heyboiiiii/PLC_ESP32/apps/readme.md

IOT_ladder_editor:**aplication to create the ladder code and get it in arduino**.

transform_code: **aplication to pass the arduino code to C for esp32(espressif) code**.

use: python rewrite.py plc.ino(generate from IOTLADDDEREDITOR) plc.c(or dest.)
