heyboiiiii/PLC_ESP32/hardware/readme.md

**circuit and schematic design were made in proteus(8.1)**.
