heyboiiiii/PLC_ESP32/docs/Carpeta Técnica PLC.pdf

# PLC

## PLC con microcontrolador ESP32

## Carpeta Técnica

Della Torre, Joaquín

Erbino, Renzo

Romero Dominguez, Braulio

Villegas González, Alejandro

2024

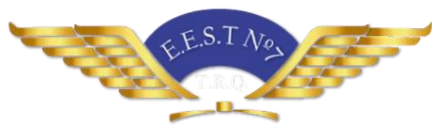
[picture p11: figure]

Índice

1. Preámbulo | 3
1.3.3. Lenguajes de programación y frameworks
2. Introducción | 4
3. Desarrollo técnico | 5
4. Placa | 9
5. Página web | 10
6. Código de la placa | 10

## 1. Preámbulo

1.1. ¿Quiénes somos?
- Braulio Romero Domínguez

Mail: braulioemilioromero7@gmail.com

DNI: 48.838.123

- Villegas González Alejandro

Mail: advillegasg@gmail.com

DNI: 48.572.234

- Della Torre Joaquín

Mail: jaoquin1234@gmail.com

DNI: 48.240.913

- Erbino Renzo

Mail: renzoerbino@gmail.com

DNI: 48.944.402

### 1.2. Docentes a cargo

- Fabrizio Carlassara
- Agustin Palmieri Hise

### 1.3. Información adicional

### 1.3.1. Tiempo invertido

- Fecha de inicio: 6 de agosto de 2024.
- Duración: 16 semanas de trabajo.
- Esfuerzo del proyecto individual: 3 horas de trabajo

semanales por integrante.

- Esfuerzo total del proyecto: 192 horas de trabajo.

### 1.3.2. Programas utilizados

- Usamos Visual Studio Code para programar el

ESP32

- iot-ladder-editor, un programa que utilizamos para

programar en Ladder. https://github.com/leofds/iot-

ladder-editor/tree/main
1.3.3. | Lenguajes | de | programación | y

frameworks utilizados

- Python
- Ladder
- C

## 2. Introducción

### 2.1. Resumen del proyecto

Se busca aplicar las funciones de un PLC tradicional, el cual a grandes rasgos se encarga de detectar diversos tipos de señales del proceso, y elaborar y enviar acciones de acuerdo con lo que se ha programado. Además, recibe configuraciones de los programadores y da reporte a los mismos, aceptando modificaciones de programación cuando son necesarias
Pero se utiliza buscando una simplificación en el ámbito de utilizar un microcontrolador ESP32 como núcleo de las operaciones, el cual estará conectado a una página web que mostrará un análisis de datos recaudados y el programa del PLC el cual podrá ser modificado siempre que se desee a través de esa página
2.2. ¿Por qué usar un PLC?

Los PLCs permiten controlar y automatizar procesos industriales, reduciendo la necesidad de intervención manual y aumentando la precisión y consistencia en las operaciones. Son como cerebros programables que hacen que las cosas funcionen automáticamente y de manera eficiente. Además, con un microcontrolador abarataríamos costo, reduciríamos el tamaño, sería más fácil de programar e incluso se le podrían añadir funciones de Wifi o Bluetooth

### 2.3. PLCs en la industria

Los PLC se usan en la automatización industrial para controlar procesos y maquinaria en industrias como la automotriz, alimentaria y química, así como en sistemas de energía, edificios y transporte automatizado por ejemplo en
automatización | de | procesos | industriales, | control | de
máquinas, sistemas de transporte y logística y gestión de energía.

### 2.4. Impacto medioambiental

Los PLCs optimizan procesos industriales, reduciendo el consumo energético al eliminar desperdicios y ajustando operaciones para usar solo la energía necesaria, además son esenciales en la operación de sistemas de energía renovable. Al mismo tiempo, contienen componentes electrónicos que requieren recursos como metales, plásticos y tierras raras para su fabricación, lo que puede generar impacto ambiental durante la extracción y procesamiento de estos materiales, teniendo en cuenta que su producción contribuye a emisiones de CO2 y que consumen energía durante su operación, y su impacto depende de la fuente de energía utilizada.

## 3. Desarrollo técnico

### 3.1. Descripción del funcionamiento

El PLC lee lo que hay en las entradas y según esto usa la lógica que dice que si tal entrada esta en tal estado activa tal salida, y dentro del ESP32 tiene varios archivos de configuración con un archivo de LCD que te muestra lo que está sucediendo. Se conecta al Wifi e inicia un servidor web con su IP, donde lo accedes y ves el estado de entradas y salidas del PLC. Manda a correr el archivo del plc.c, donde está la lógica del PLC que al cambiar algún estado se refresca la pagina, después de iniciar el servidor web.

### 3.1.1 Descripción de las entradas

Las borneras tienen las entradas digitales y analógicas (I1 a I4 e IA5 a IA6 respectivamente) y también poseen los 24V y su GND. N solo cumple la función de neutro respecto a todas las entradas digitales, mientras que el neutro de las analógicas es IN-.

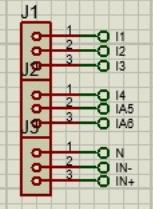
[picture p12: figure]

Posee cuatro de las seis entradas digitales, estas funcionan con un optoacoplador el cual es generalmente utilizado para reducir la señal eléctrica que ingresa de 12V o 24V a un rango de 0 a 3.3V, lo que el microcontrolador es capaz de soportar. Este método es generalmente usado para las entradas de los microprocesadores.

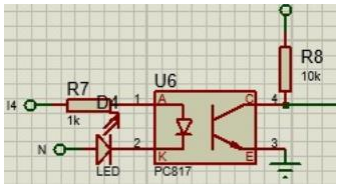
[picture p13: figure]

En las entradas analógicas tenemos una reducción de tensión, que pasará de 0V-10V a una menor, que pueda aceptar el microcontrolador, mediante una relación a través de la primera parte. Luego tenemos un seguidor de tensión que separa la entrada de la salida que luego va conectada al microcontrolador.

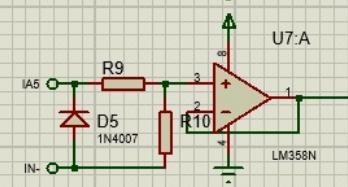
[picture p14: figure]

### 3.1.2 Descripción de las salidas

Tiene una salida con etapa de potencia de relé, la cual funciona a través del mecanismo básico de etapa de potencia de relé y es uno de los dos tipos de salida que posee el PLC. Esto se realiza de esta manera para tener el control de las salidas de grandes potencias de una manera más segura y eficiente.

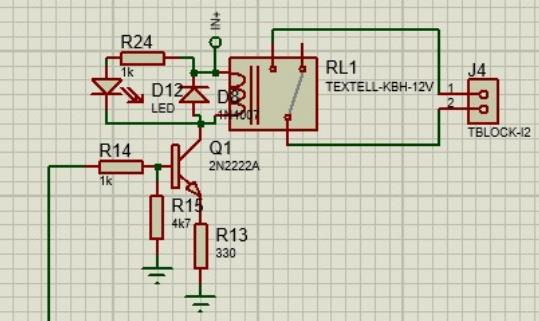
[picture p15: figure]

Las salidas transistorizadas en un PLC se utilizan cuando se requiere una respuesta rápida, un alto número de conmutaciones y el manejo de señales digitales, pero con la limitación de manejar cargas de menor potencia que las salidas de relé.

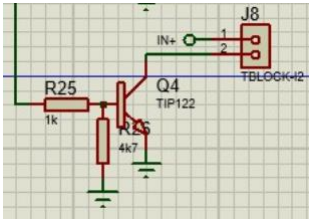
[picture p16: figure]
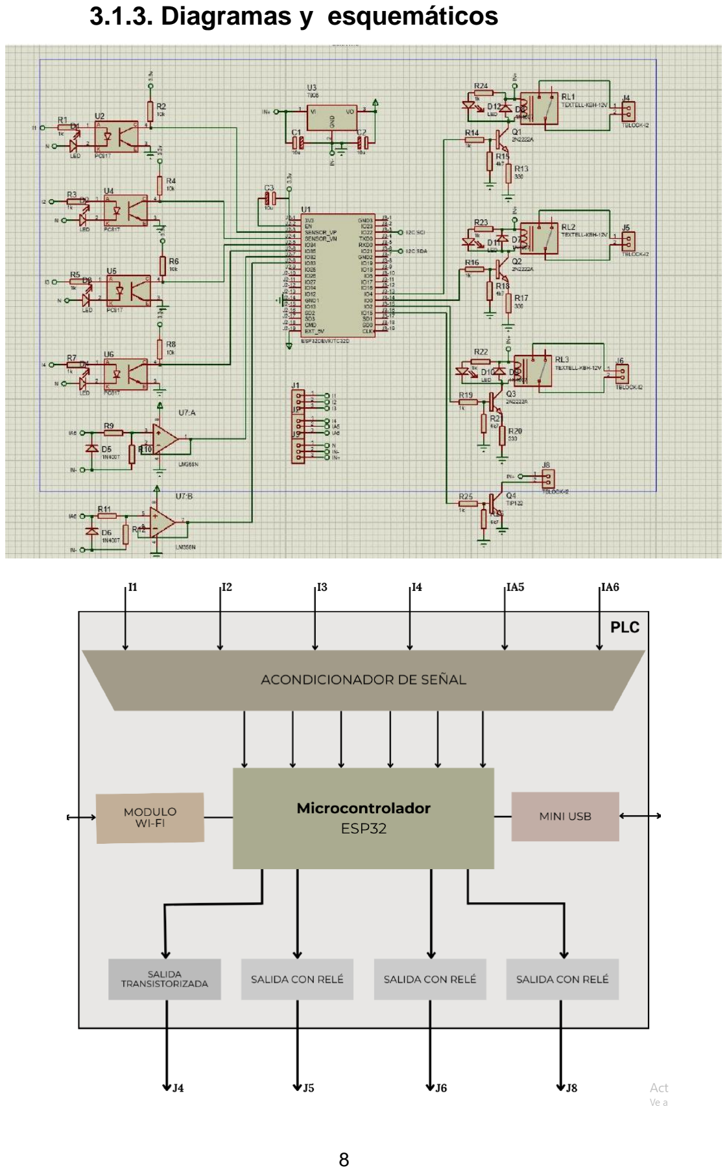
[picture p17: page 8]

### 3.1.3. Diagramas y esquemáticos

## 4. Placa

### 4.1. Componentes

- U1 – ESP32
- U2, U4, U5, U6 – PC817
- U3 – LM7805
- U7 – LM358N
- Q1, Q2, Q3 – 2N2222A
- Q4 – TIP122
- 26x Resistencia
- 8x Bornera
- 12x Diodo
- 3x Relé
- 3x Capacitor

### 4.2. Costos

- ESP32 ≈ 10000$
- 4x PC817 ≈ 3000$
- LM7805 ≈ 2500$
- LM358N ≈ 3400$
- 3x 2N2222A ≈ 2300$
- TIP122 ≈ 2500$
- 26x Resistencia ≈ 2000$
- 8x Bornera ≈ 6000$
- 12x Diodo ≈ 5000$
- 3x Relé ≈ 4000$
- 3x Capacitor ≈ 1000$

Precio total ≈ 41700$

## 5. Página

### 5.1. Funcionamiento

Al entrar a la página tienes un web_server.c, el código del servidor web que describe los eventos, es decir, que hacer cuando alguien entra a la página, que mostrarle y le devuelve el html con el javascript dentro y te muestra las entradas y salidas del PLC, de forma paralela es decir, que si se altera el estado de una de las entradas o salidas se refresca la página.

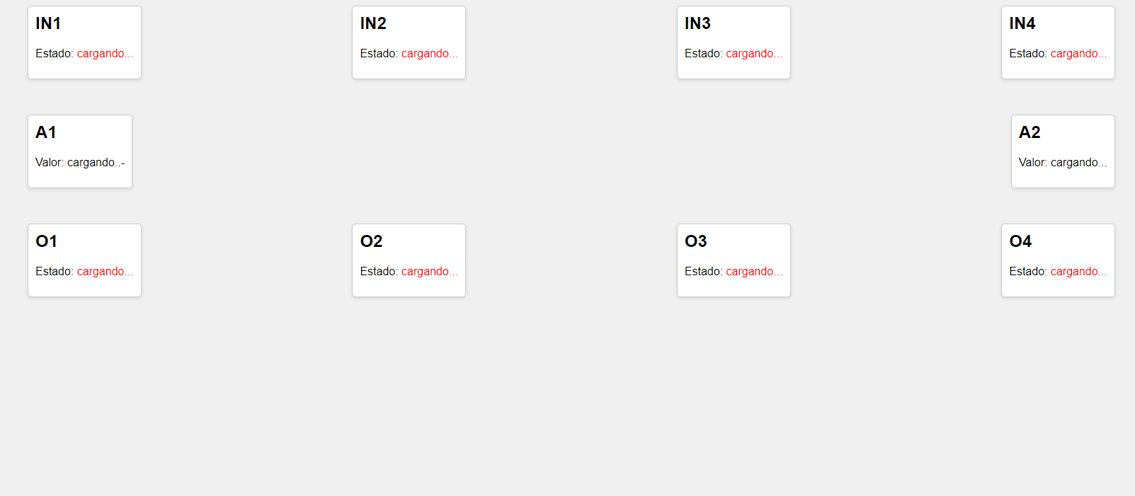
[picture p18: figure]

## 6. Código de la placa

### 6.1. Lenguaje Ladder

Este es un lenguaje de programación gráfica utilizado principalmente para programar PLCs. Es muy popular en la automatización industrial debido a su similitud con los diagramas eléctricos utilizados tradicionalmente en circuitos de control eléctrico y su facilidad de interpretación por parte de técnicos e ingenieros, especialmente para aquellos que migran de sistemas de relés a sistemas programables. Por otra parte, se optimizó el código para que no ocupe espacio en memoria

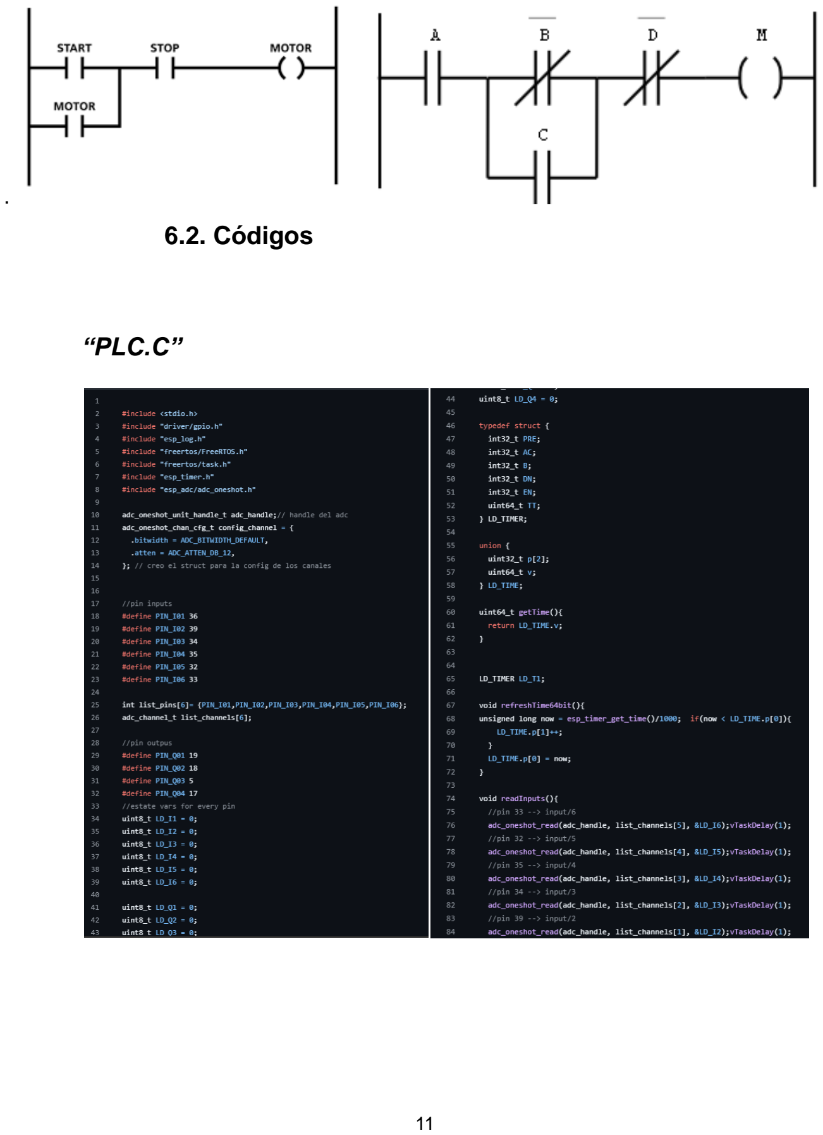
[picture p19: page 11]

### 6.2. Códigos

“PLC.C”

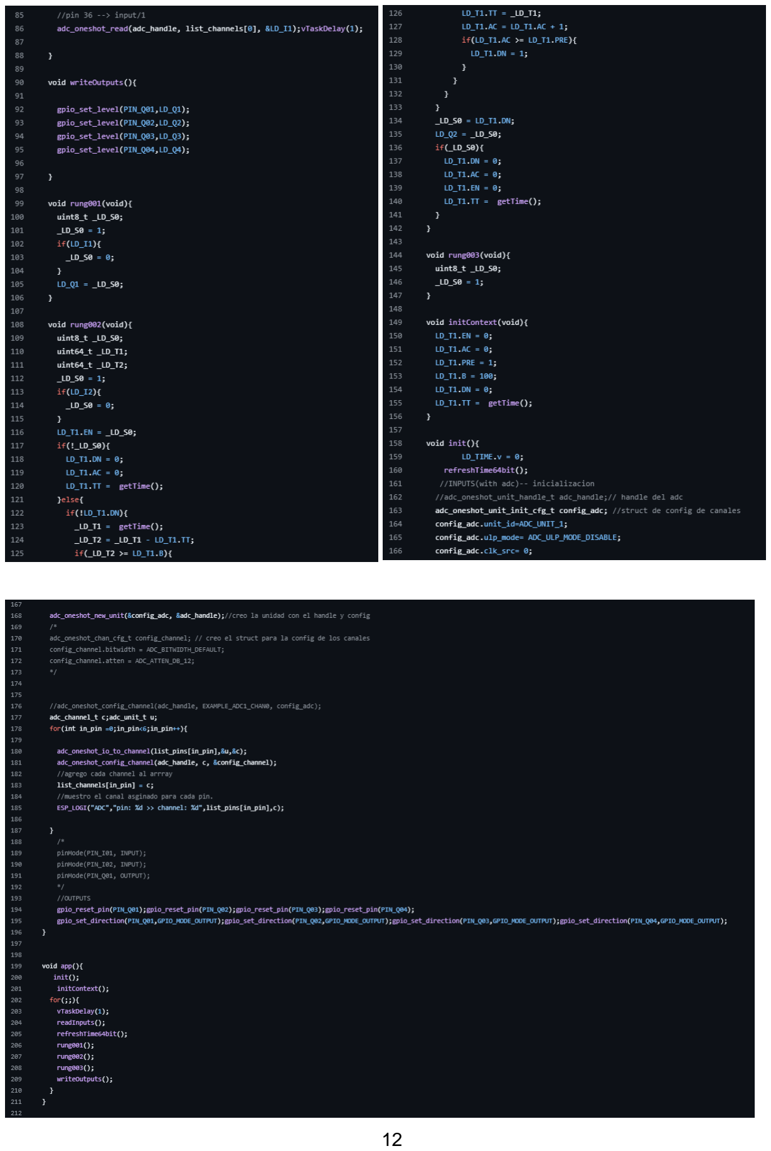
[picture p20: page 12]
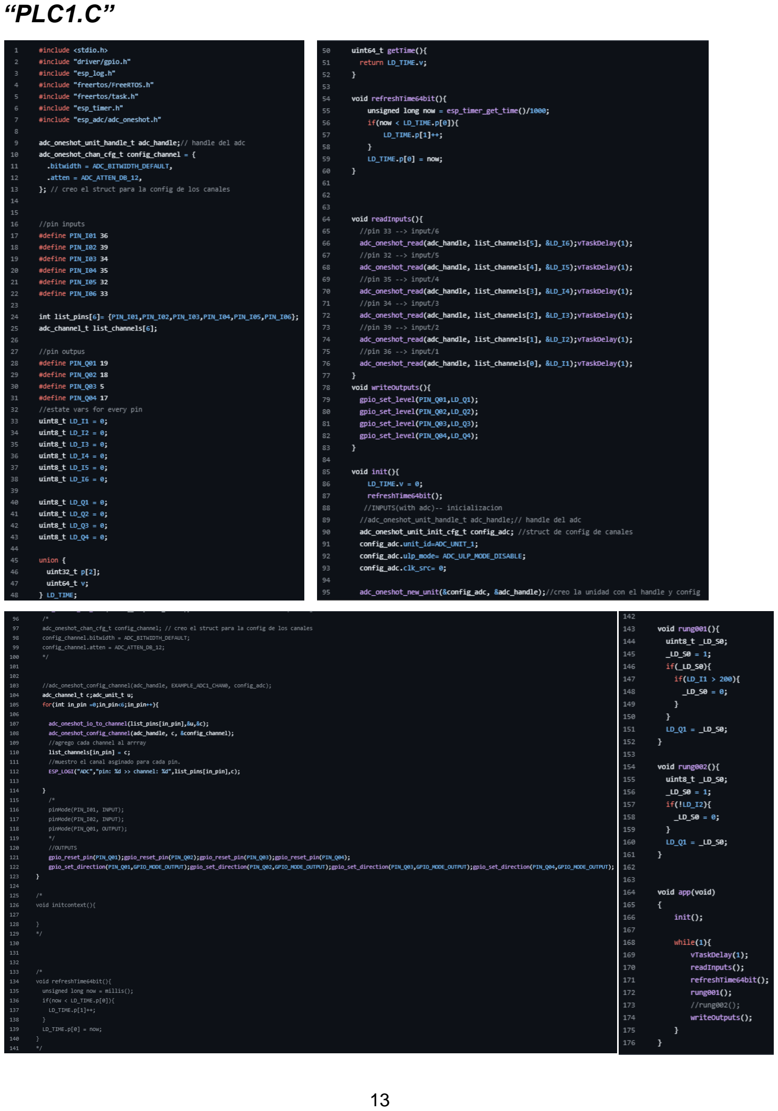
[picture p21: page 13]

“PLC1.C”

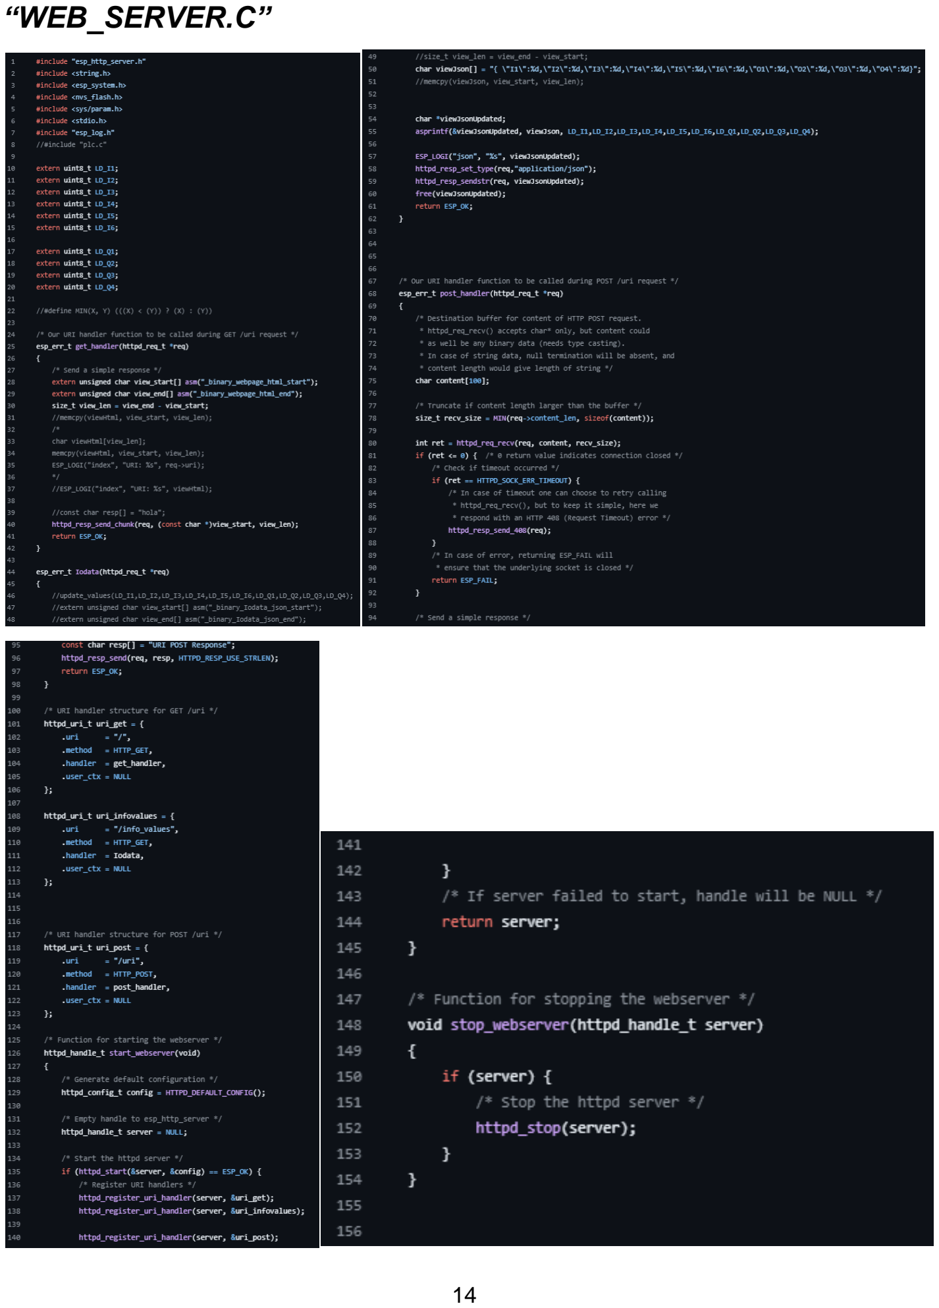
[picture p22: page 14]

“WEB_SERVER.C”

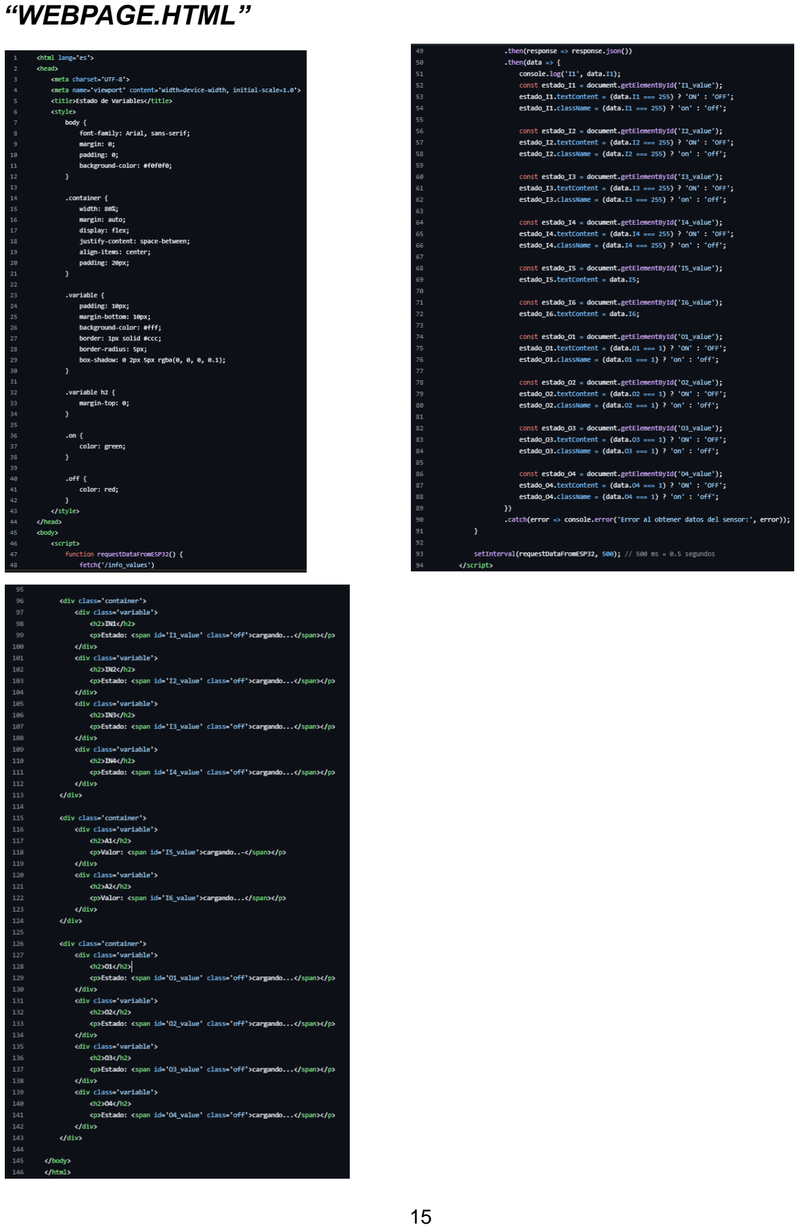
[picture p23: page 15]

“WEBPAGE.HTML”

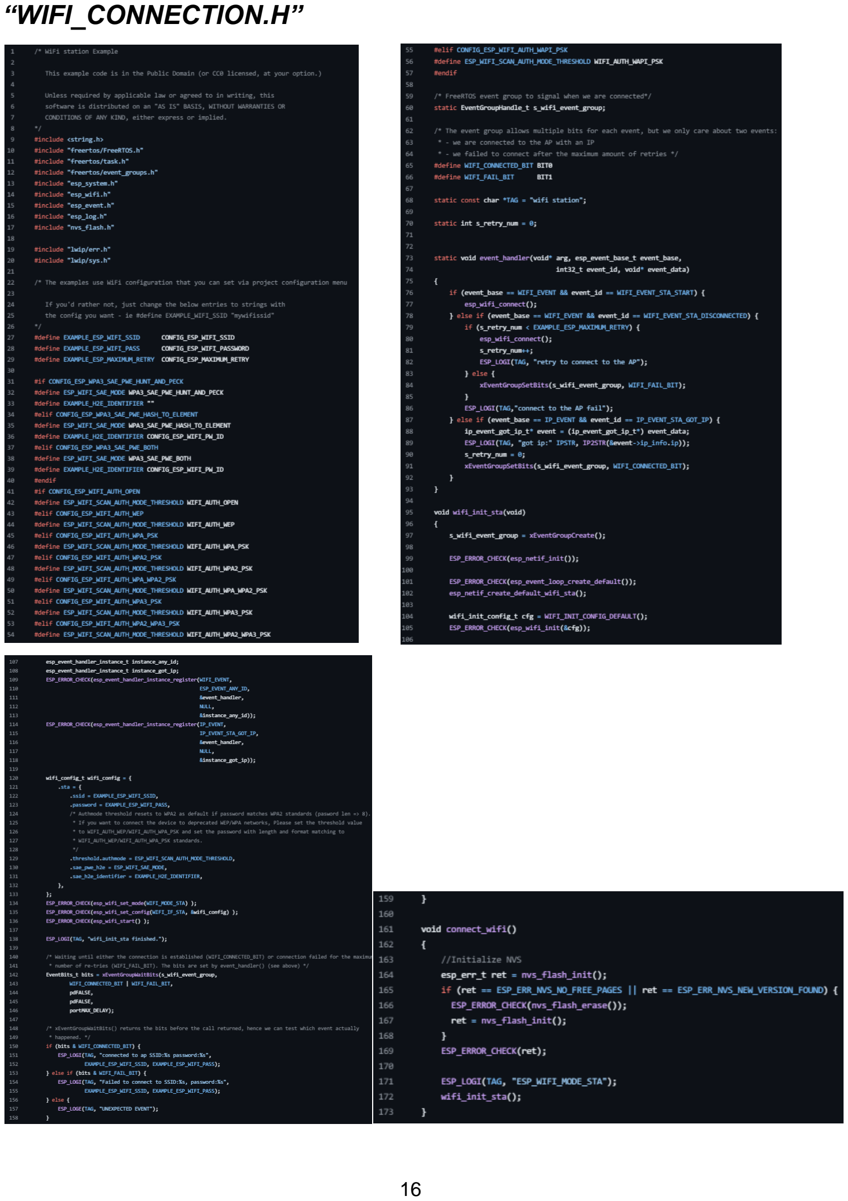
[picture p24: page 16]

“WIFI_CONNECTION.H”
