heyboiiiii/PLC_ESP32/mechanical/techo.stl

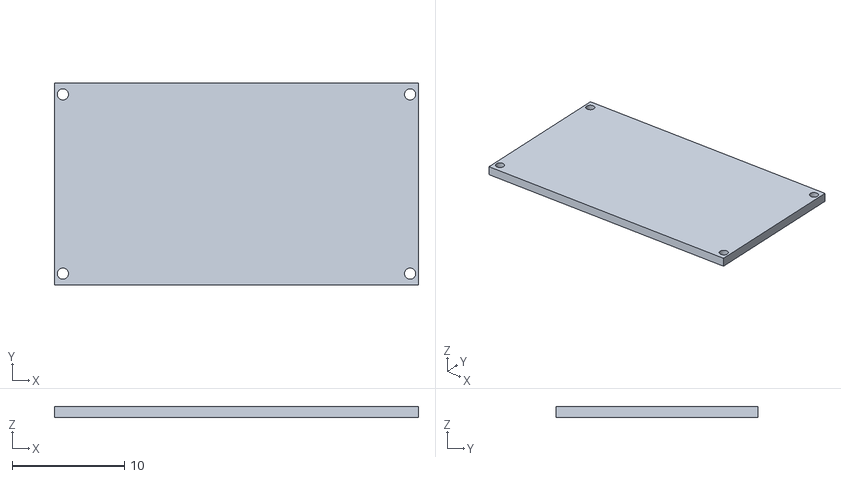
[picture p35: CAD file, 2024-11-26]
mechanical/techo.stl
32.5 x 18.0 x 1.00
