heyboiiiii/PLC_ESP32/mechanical/piso.stl

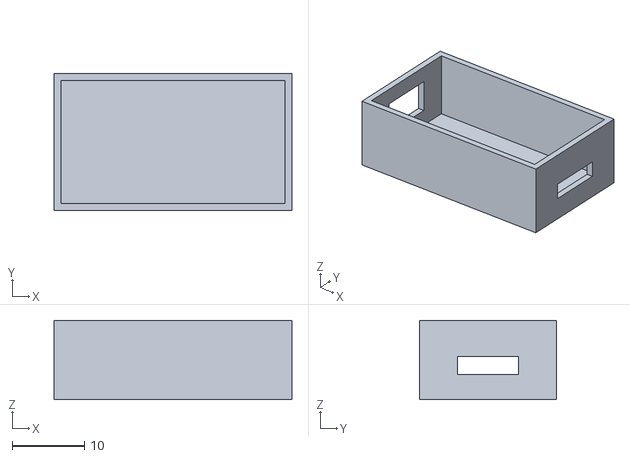
[picture p36: CAD file, 2024-11-26]
mechanical/piso.stl
33.0 x 19.0 x 11.0
