heyboiiiii/PLC_ESP32/(list of files, drawings)

Other design files:
hardware/Circuito_PLC/PLC_ESP32.pdsprj
