heyboiiiii/PLC_ESP32/firmware/PLC_ESP32/main/main.h

extern uint8_t LD_I1;
extern uint8_t LD_I2;
extern uint8_t LD_I3;
extern uint8_t LD_I4;
extern uint8_t LD_I5;
extern uint8_t LD_I6;

extern uint8_t LD_Q1;
extern uint8_t LD_Q2;
extern uint8_t LD_Q3;
extern uint8_t LD_Q4;
extern char IP_ESP32[];
